HugoFishx/SmartCurtain/(commit log)

2020-12-11 camera init
2020-12-12 arduino py
